rodgraneiro/UFABC-Medidor-de-Impedancia/README.md

# UFABC---Medidor-de-Impedancia

Comentário inserido por Olavo para testar o Visual Studio Code

### Exemplo de código
~~~
$ mkdir /home/olavo/github
$ cd /home/olavo/github
~~~
