rodgraneiro/UFABC-Medidor-de-Impedancia/Fcorrente_2021_06_08_prj/Circuito_eletronico_FCorrente_atual.md

# Fonte de Corrente - Circuito eletrônico atual

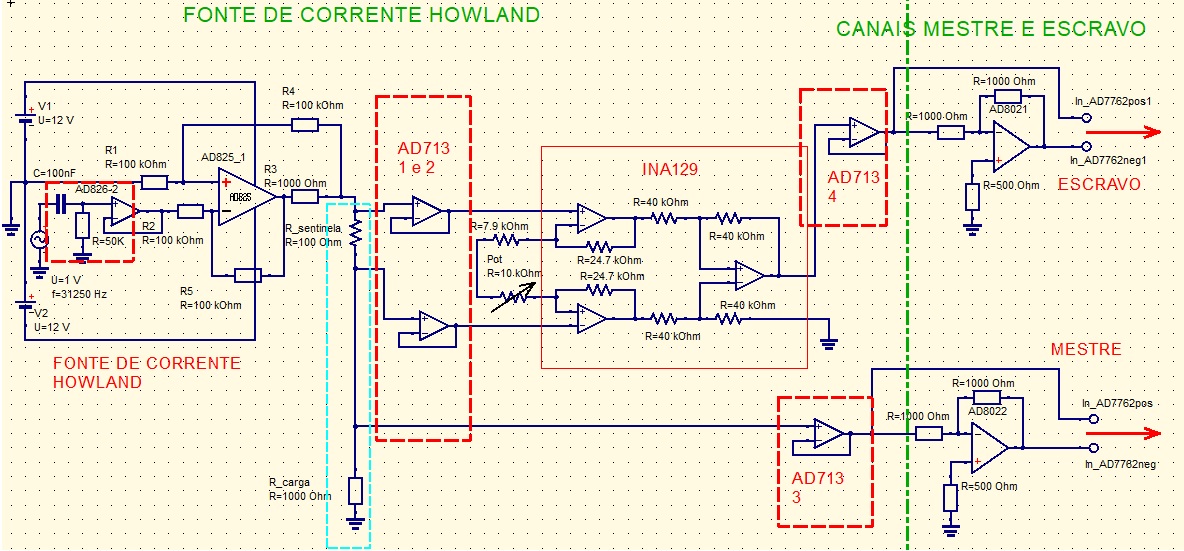
[picture p1: Fcorrente_2021_06_08_prj/FCorrente_Esquema_atual.jpg]
