rodgraneiro/UFABC-Medidor-de-Impedancia/Outros/Apresentação 625kHz.pdf

# Análise pto errático Sample Rate 156.25kHz

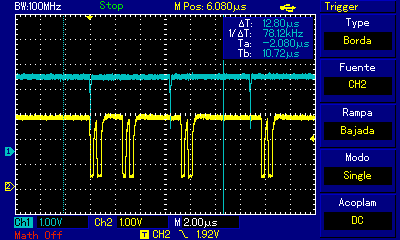
[picture p2: figure]

Foto: sinais
DRDY->

CS->

S.R. 156.25 kHz
Ch Mestre

# Nova metodologia de medição

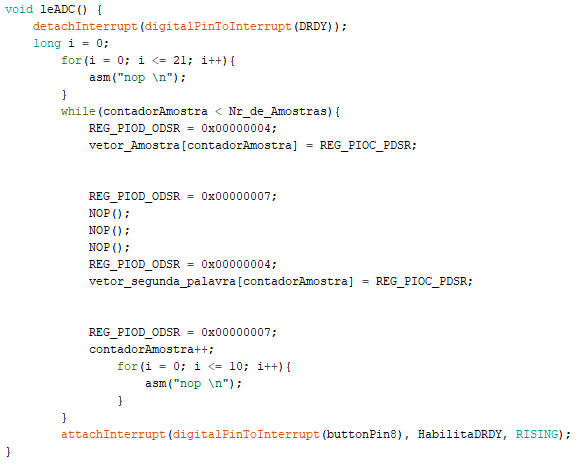
[picture p3: figure]
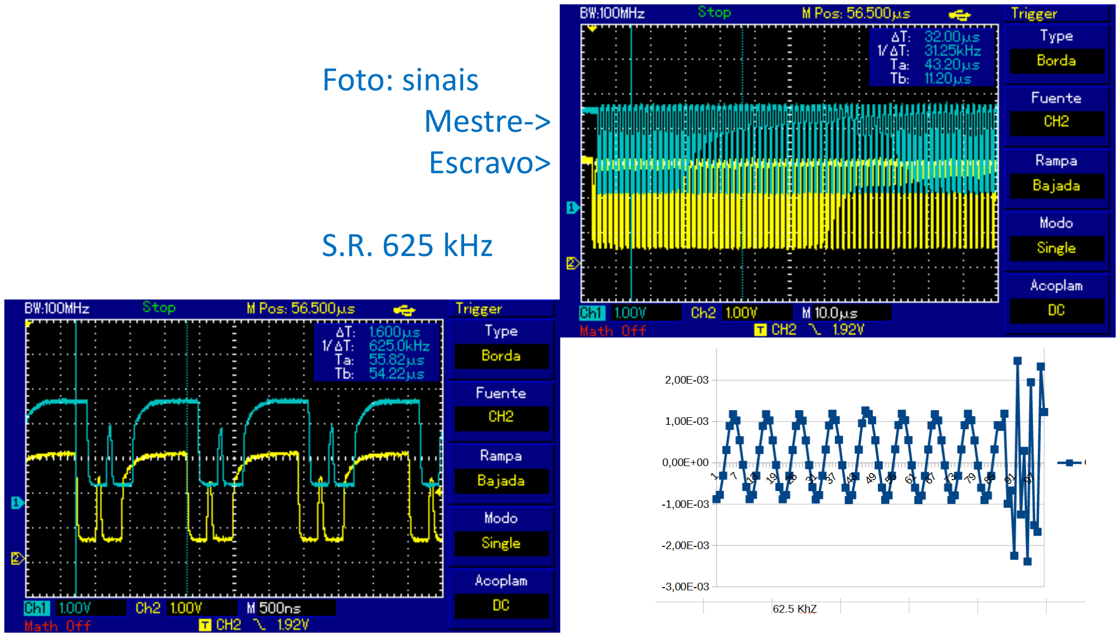
[picture p4: page 4]

Foto: sinais
Mestre->
Escravo>

S.R. 625 kHz

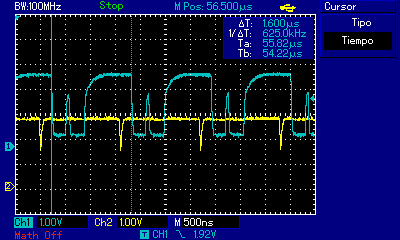
[picture p5: figure]

Foto: sinais
CS->

DRDY->

S.R. 625 kHz
Ch Mestre

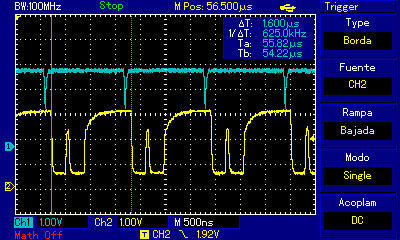
[picture p6: figure]

Foto: sinais
DRDY>

CS>

S.R. 625 kHz
Ch Escravo

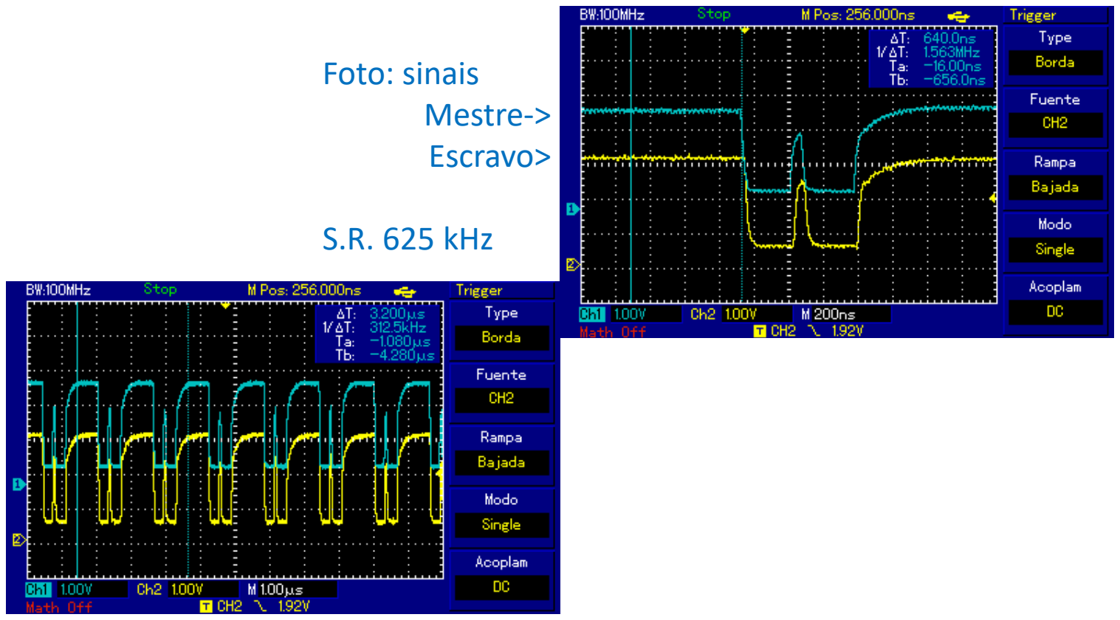
[picture p7: page 7]

Foto: sinais
Mestre->
Escravo>

S.R. 625 kHz

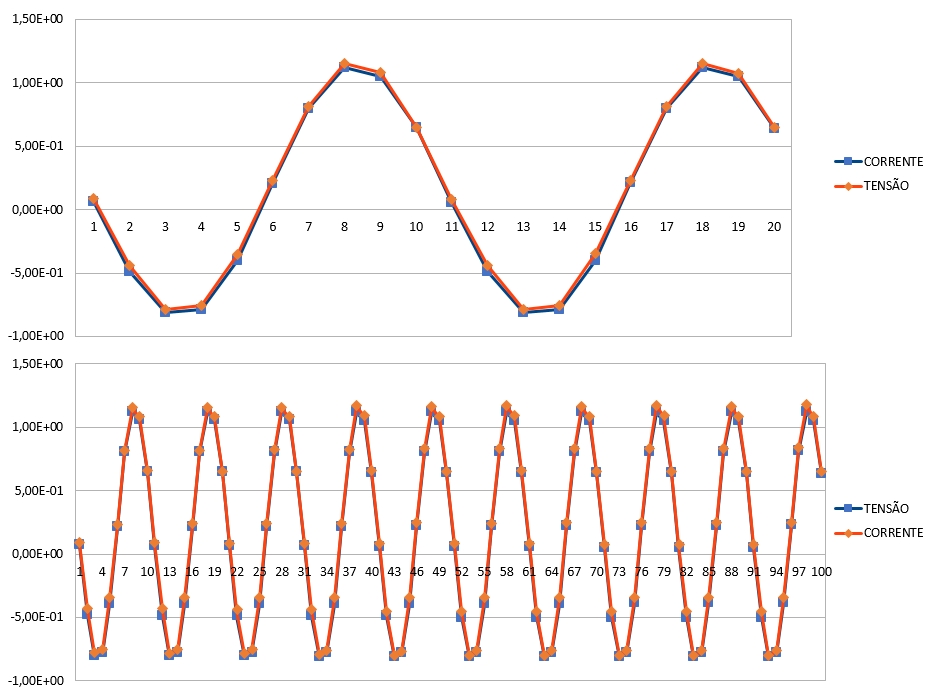
[picture p8: page 8]

Medição 1
62,5 kHz
S.R. 625 kHz

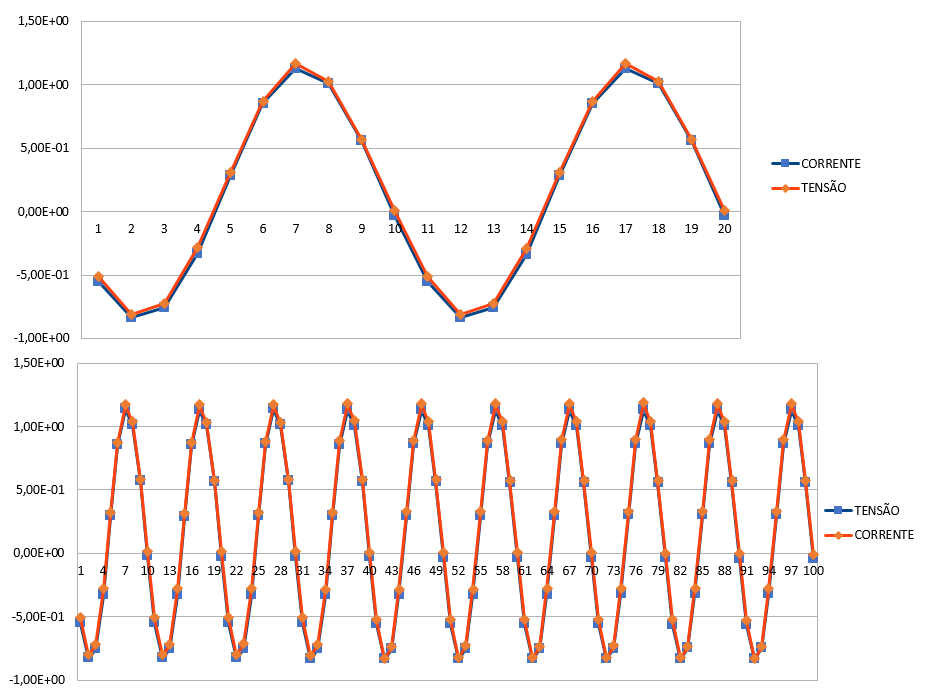
[picture p9: page 9]

Medição 2
62,5 kHz
S.R. 625 kHz

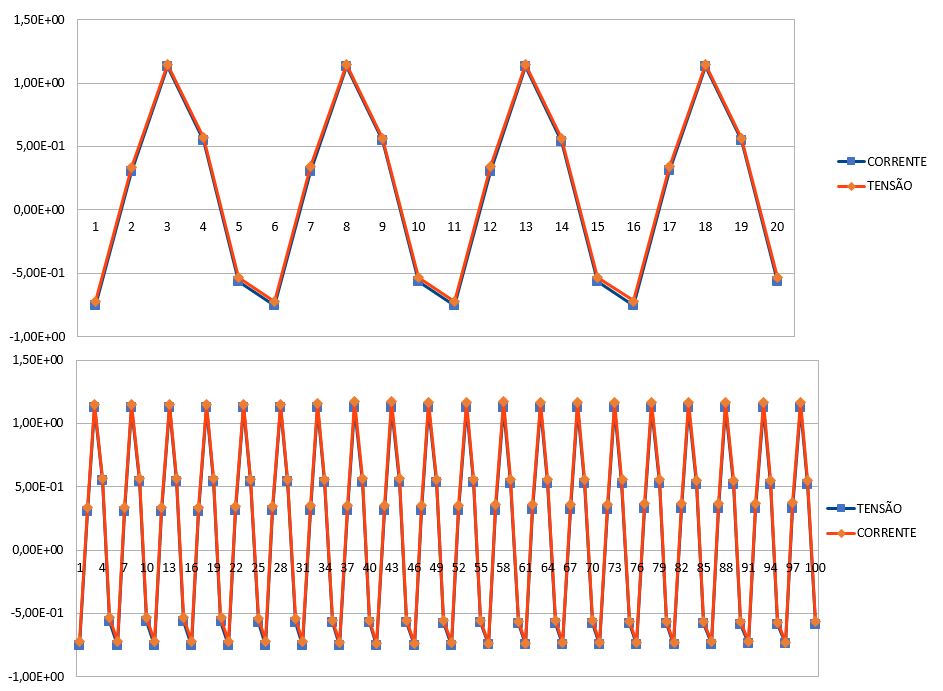
[picture p10: page 10]

Medição 3
125 kHz
S.R. 625 kHz

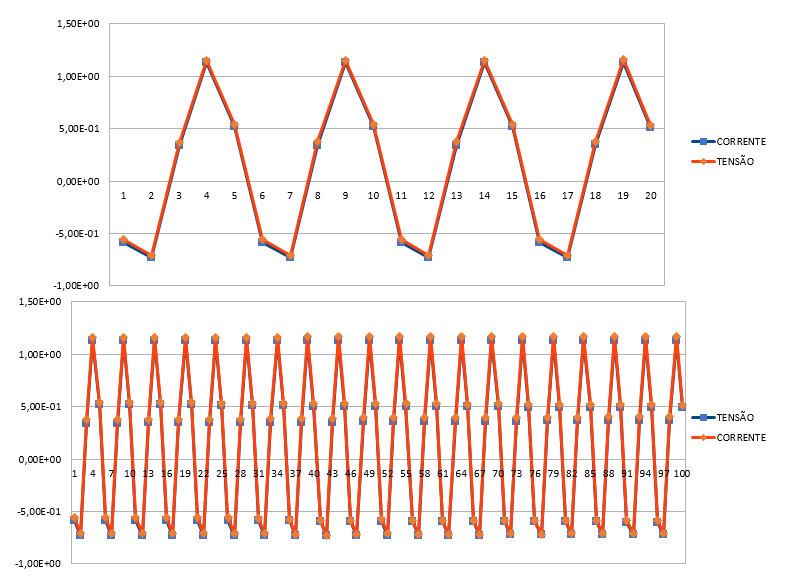
[picture p11: figure]

Medição 4
125 kHz
S.R. 625 kHz
