rodgraneiro/UFABC-Medidor-de-Impedancia/Outros/Dados para Erick completo.jpg

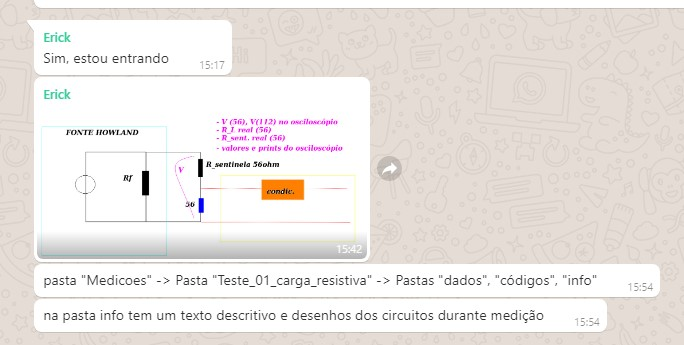
Outros/Dados para Erick completo.jpg
