rodgraneiro/UFABC-Medidor-de-Impedancia/Medicoes/Teste_03_Medicao_com RESISTORES/Info/Procedimento da medição.md

## Medição da impedânia de um trimpot tipo 3006P 103 (1K)com o MIE.

O arquivo /Dados/SoTRIMPOT.txt contém 26 pontos de medição da
resistência do trimpot com valores de zero à 2500 Ohms variando em passos de 100 Ohms
medidos com um multímetro digital e dos valores de impedância Z e fase medidas com o MIE conforme figura.
Os valores de resistividade superiores a capacidade nominal do trimpot (1k) foram medidos
com o auxílio de resistores soldados em série.

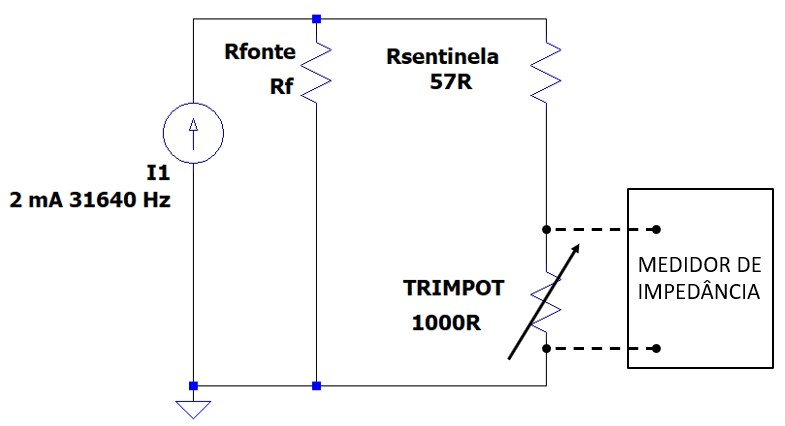
[picture p28: Medicoes/Teste_02_Medicao_com TRIMPOT/Info/Circuito_eletronico.jpg]
Circuito eletrônico do teste


Cada ponto da curva é a média trimada de mil medições efetuadas pelo MIE onde foram eliminadas
o quarcentil superior e inferior das amostras. Os cálculos foram efetuados no Matlab através do código 
/Codigo/SortMatlab_tst_new.m onde cada arquivo "TRIMPOT_r_XXXXXX_2021jul12.txt" foi substituido nas
linhas de código 2 e 3.

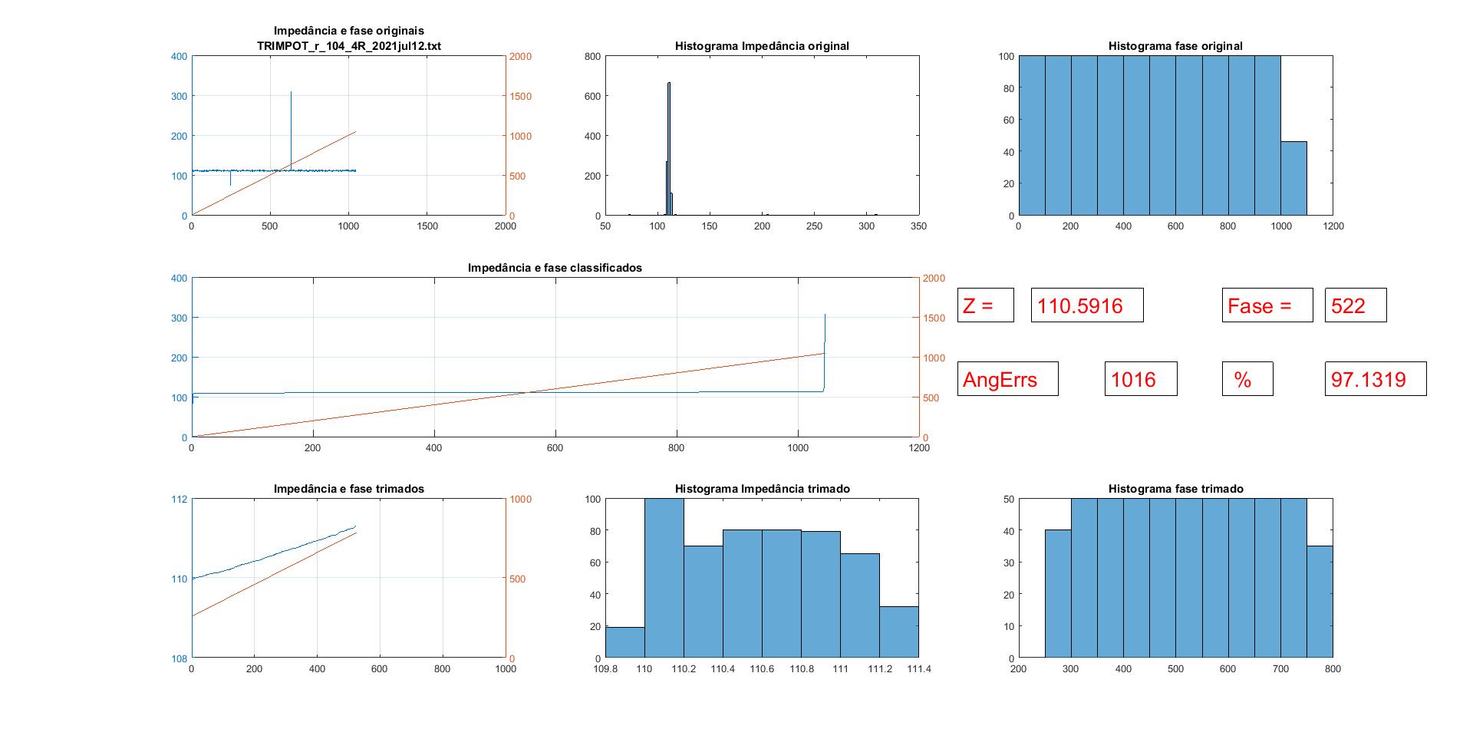
[picture p29: Medicoes/Teste_02_Medicao_com TRIMPOT/Info/ExemploMedTrimpot.jpg]
Exemplo de medição de resistividade de 100 Ohms on trimpot


A curva de Impedância Multímetro vs Impedância MIE (/Info/Curva_Z_Fase_TRIMPOT) foi efetuada através 
do código em Matlab no arquivo /Codigo/Somente_TRIMPOT.m e pode ser vista a seguir.

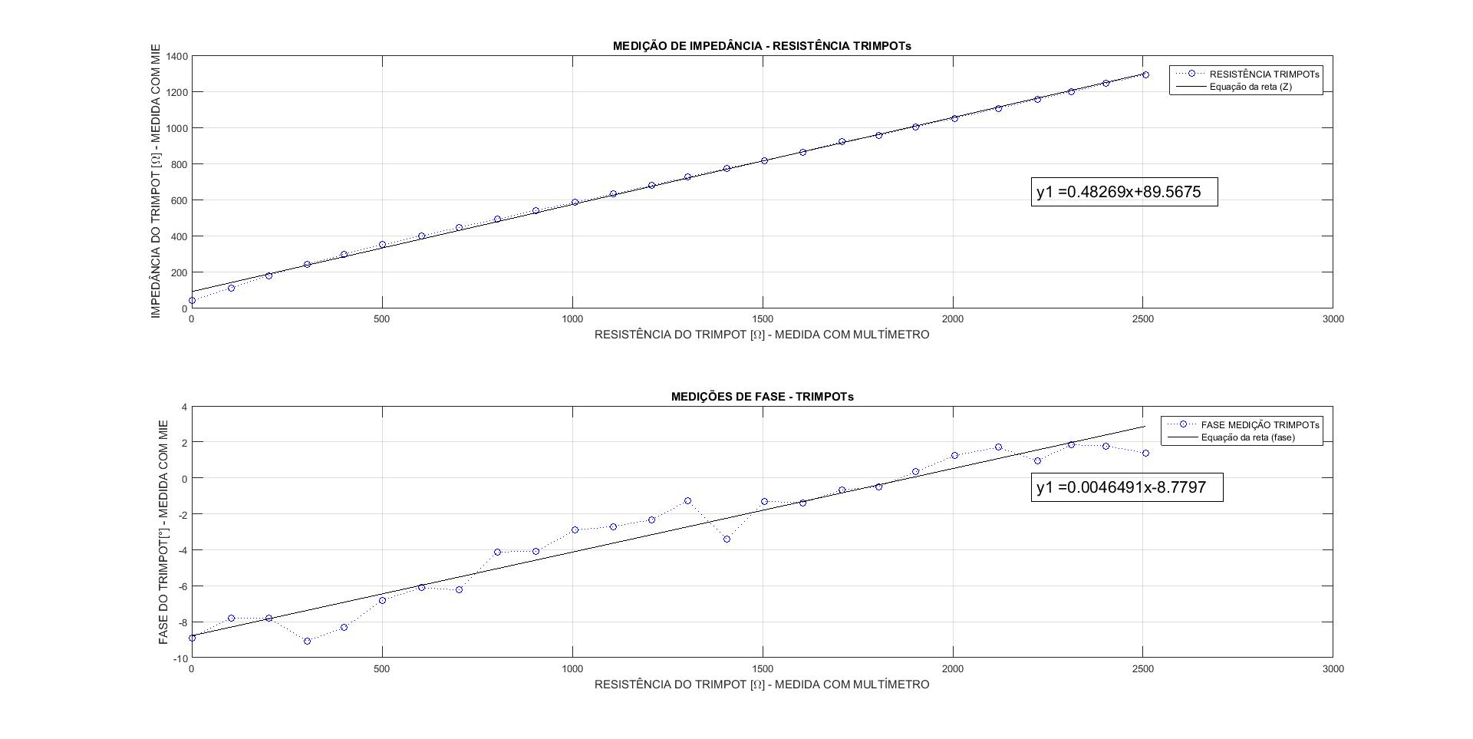
[picture p30: Medicoes/Teste_02_Medicao_com TRIMPOT/Info/Figuras/Curva_Z_Fase_TRIMPOT.jpg]
Impedância Multímetro vs Impedância MIE
 

Trimpot utilizado:

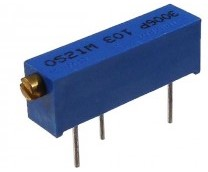
[picture p31: Medicoes/Teste_02_Medicao_com TRIMPOT/Info/Figuras/trimpot3006P.jpg]
TRIMPOT 3006P 103
