rodgraneiro/UFABC-Medidor-de-Impedancia/Medicoes/Teste_01_Resistencia_interna_FCorrente/Info/Med_Rsent_Rload_e_Frequencia.pdf

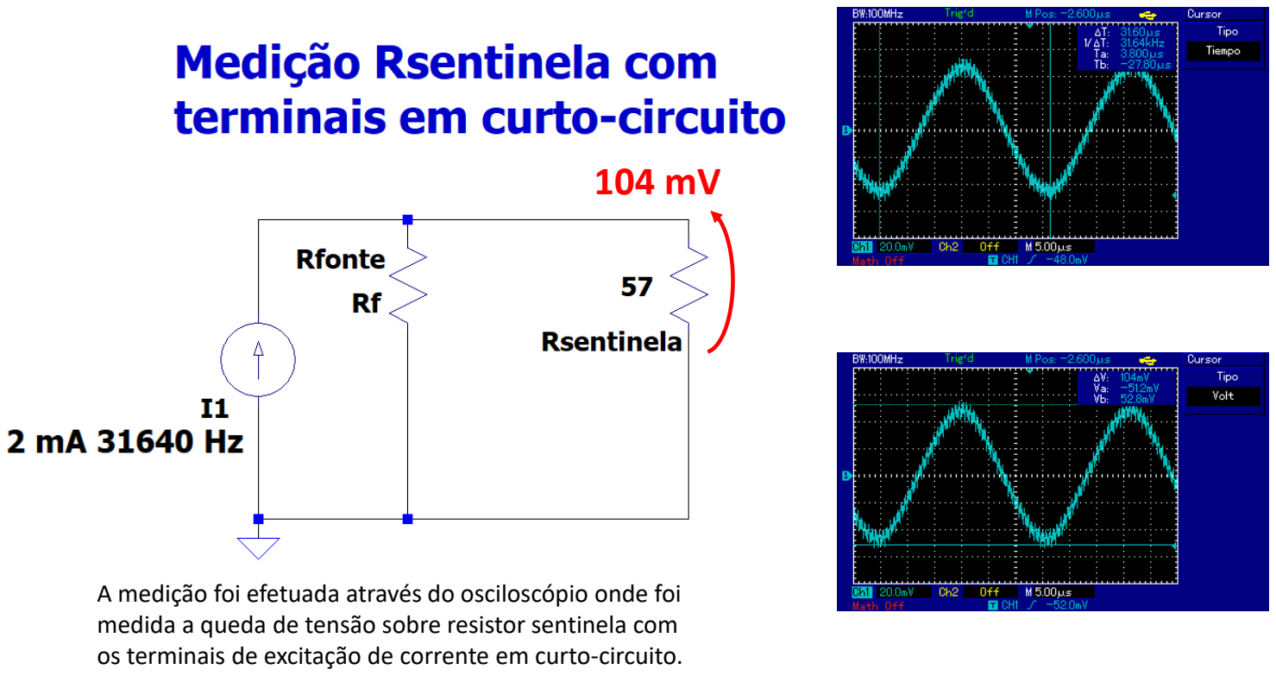
[picture p32: page 1]

104 mV

A medição foi efetuada através do osciloscópio onde foi medida a queda de tensão sobre resistor sentinela com os terminais de excitação de corrente em curto-circuito.

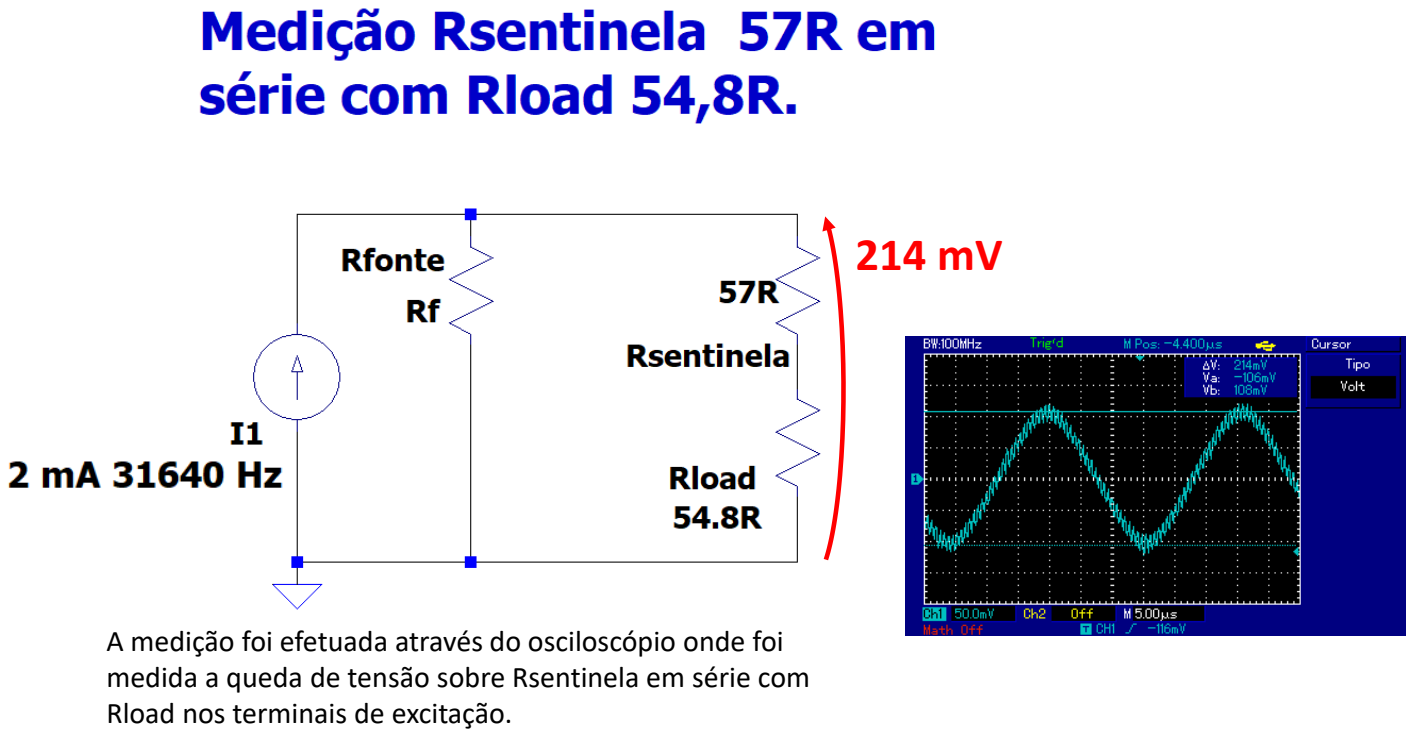
[picture p33: page 2]

214 mV

A medição foi efetuada através do osciloscópio onde foi medida a queda de tensão sobre Rsentinela em série com Rload nos terminais de excitação.
