rodgraneiro/UFABC-Medidor-de-Impedancia/Medicoes/Teste_01_Resistencia_interna_FCorrente/Dados/estudoCabecalho_DAT.xlsx

Sheet: Planilha1
0 | 0 | 0 | 0 | 0
17402 | 17224 | 17096 | 16968 | 16800 | 178 | 128 | 128 | 168
0 | 0 | 0 | 0 | 0
17530 | 17530 | 17530 | 17530 | 17530
129 | 129 | 129 | 129 | 129
3 | 3 | 3 | 3 | 3
12 | 12 | 12 | 12 | 12
2321 | 2320 | 2319 | 2318 | 2317 | 1 | 1 | 1 | 1
0 | 0 | 0 | 0 | 0
130 | 105 | 155 | 113 | 121
144 | 106 | 155 | 110 | 120
112 | 110 | 152 | 108 | 119
106 | 121 | 147 | 107 | 117
112 | 135 | 140 | 106 | 116
145 | 148 | 133 | 105 | 116
129 | 155 | 127 | 105 | 114
106 | 149 | 119 | 105 | 114
106 | 137 | 115 | 106 | 112
127 | 123 | 109 | 106 | 111
146 | 112 | 106 | 108 | 110
114 | 106 | 106 | 109 | 109
106 | 106 | 105 | 112 | 108
110 | 108 | 106 | 115 | 108
141 | 116 | 110 | 118 | 107
132 | 129 | 114 | 120 | 106
107 | 142 | 120 | 124 | 106
105 | 153 | 126 | 127 | 105
123 | 153 | 133 | 131 | 105
149 | 143 | 139 | 133 | 105
116 | 129 | 146 | 137 | 105
105 | 116 | 151 | 140 | 105
108 | 108 | 154 | 144 | 105
138 | 105 | 156 | 146 | 105
134 | 107 | 154 | 149 | 105
108 | 113 | 150 | 152 | 106
106 | 124 | 145 | 153 | 106
120 | 139 | 139 | 154 | 106
152 | 150 | 131 | 155 | 106
119 | 155 | 124 | 155 | 107
106 | 147 | 118 | 155 | 108
108 | 134 | 113 | 155 | 107
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
