rodgraneiro/UFABC-Medidor-de-Impedancia/Medicoes/Teste_06_Superficie_3D_R_C_Xc_Z/Dados/Dados_simulacao_Z_LTSpice_R_paral_C.xlsx

Sheet: R2350
 |  | MIE |  | LTSpice |  | DIFERENÇA
 |  | |z| | fase | |z| | fase | |z| | fase
2350 | 1.02e-06 | 39.26 | -13.99 | 4.98 | -89.87 | 34.28 | 75.88
2350 | 4.7e-07 | 39.92 | -19.66 | 10.83 | -89.73 | 29.09 | 70.07
2350 | 3.37e-07 | 40.53 | -24.09 | 15.13 | -89.63 | 25.40 | 65.54
2350 | 2.26e-07 | 42.75 | -30.4 | 22.53 | -89.45 | 20.22 | 59.05
2350 | 1.01e-07 | 53.14 | -49.4 | 50.41 | -88.77 | 2.73 | 39.37
2350 | 4.75e-08 | 87.87 | -69.52 | 107.11 | -87.39 | -19.24 | 17.87
2350 | 2.02e-08 | 142.27 | -77.37 | 250.69 | -83.88 | -108.42 | 6.51
2350 | 1.03e-08 | 328.57 | -78.36 | 493.03 | -77.89 | -164.46 | -0.47
2350 | 4.2e-09 | 607.09 | -60.78 | 1078.00 | -62.71 | -470.91 | 1.93
2350 | 3.2e-09 | 756.94 | -50.72 | 1318.00 | -55.89 | -561.06 | 5.17
2350 | 2.82e-09 | 812.66 | -46.81 | 1432.00 | -52.46 | -619.34 | 5.65
2350 | 2.53e-09 | 873.74 | -42.81 | 1529.00 | -49.42 | -655.26 | 6.61
39.26 | 39.92 | 40.53 | 42.75 | 53.14 | 87.87 | 142.27 | 328.57 | 607.09 | 756.94 | 812.66 | 873.74
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
