rodgraneiro/UFABC-Medidor-de-Impedancia/Medicoes/Teste_01_Resistencia_interna_FCorrente/Info/Medicao_tensao_corrente_osciloscopio.xlsx

Rsentinela | Rload | Rtotal | Delta_V | Itotal
[OHM] | [OHM] | [OHM] | [mVp-p] | [mApp]
57 | 0 | 57 | 101 | 1.77
57 | 1.1 | 58.1 | 102 | 1.76
57 | 5.1 | 62.1 | 113 | 1.82
57 | 9.8 | 66.8 | 119 | 1.78
57 | 14.9 | 71.9 | 126 | 1.75
57 | 27.5 | 84.5 | 136 | 1.61
57 | 54.8 | 111.8 | 200 | 1.79
57 | 99.5 | 156.5 | 300 | 1.92
57 | 219.8 | 276.8 | 548 | 1.98
57 | 297 | 354 | 684 | 1.93
57 | 497 | 554 | 1080 | 1.95
57 | 667 | 724 | 1380 | 1.91
57 | 1630 | 1687 | 3140 | 1.86
57 | 1941 | 1998 | 3760 | 1.88
57 | 2350 | 2407 | 4360 | 1.81
