rodgraneiro/UFABC-Medidor-de-Impedancia/Medicoes/Teste_01_Resistencia_interna_FCorrente/Dados/Medicao_tensao_corrente_osciloscopio.xlsx

Rsentinela | Rload | Rtotal | Delta_V | Itotal
[OHM] | [OHM] | [OHM] | [mVp-p] | mApp
57 | 0 | 57 | 101 | 1.771929825
57 | 1.1 | 58.1 | 102 | 1.755593804
57 | 5.1 | 62.1 | 113 | 1.819645733
57 | 9.8 | 66.8 | 119 | 1.781437126
57 | 14.9 | 71.9 | 126 | 1.752433936
57 | 27.5 | 84.5 | 136 | 1.609467456
57 | 54.8 | 111.8 | 200 | 1.788908766
57 | 99.5 | 156.5 | 300 | 1.916932907
57 | 219.8 | 276.8 | 548 | 1.979768786
57 | 297 | 354 | 684 | 1.93220339
57 | 497 | 554 | 1080 | 1.949458484
57 | 667 | 724 | 1380 | 1.906077348
57 | 1630 | 1687 | 3140 | 1.861292235
57 | 1941 | 1998 | 3760 | 1.881881882
57 | 2350 | 2407 | 4360 | 1.811383465
