rodgraneiro/UFABC-Medidor-de-Impedancia/Medicoes/Teste_02_Medicao_com TRIMPOT/Dados/TRIMPOT.xlsx

TRIMPOT | MIE | fase | erros | %
0 | 39.21 | -8.9 | 52 | 4.96
104.4 | 110.59 | -7.79 | 39 | 3.72
201.9 | 178.02 | -7.8 | 37 | 3.55
302.9 | 241.13 | -9.07 | 43 | 4.11
401 | 296.99 | -8.33 | 56 | 5.35
501 | 349.02 | -6.8 | 36 | 3.46
603 | 398.35 | -6.11 | 39 | 3.72
702 | 445.12 | -6.23 | 54 | 5.15
