rodgraneiro/UFABC-Medidor-de-Impedancia/Medicoes/Teste_Laboratorio_L001/1cope_0sinc_01curto_.csv

-100.600E-06 -7.574592E-03
-100.500E-06 -23.081815E-03
-100.400E-06 -12.670383E-03
-100.300E-06 -5.643059E-03
-100.200E-06 -28.130496E-03
-100.100E-06 -34.121388E-03
-100.000E-06 -40.787531E-03
-99.900E-06 -23.403737E-03
-99.800E-06 -13.997330E-03
-99.700E-06 -6.467494E-03
-99.600E-06 -25.947707E-03
-99.500E-06 -33.571765E-03
-99.400E-06 -37.340609E-03
-99.300E-06 +881.753E-06
-99.200E-06 +709.014E-06
-99.100E-06 -2.800722E-03
-99.000E-06 -20.639918E-03
-98.900E-06 -10.212782E-03
-98.800E-06 -2.965609E-03
-98.700E-06 +2.467808E-03
-98.600E-06 +3.912531E-03
-98.500E-06 -350.974E-06
-98.400E-06 -19.956815E-03
-98.300E-06 -10.322707E-03
-98.200E-06 -3.373901E-03
-98.100E-06 -1.952732E-03
-98.000E-06 -18.221576E-03
-97.900E-06 -7.456815E-03
-97.800E-06 -1.544441E-03
-97.700E-06 -22.704931E-03
-97.600E-06 -29.622330E-03
-97.500E-06 -34.749528E-03
-97.400E-06 -18.645571E-03
-97.300E-06 -7.166300E-03
-97.200E-06 -115.421E-06
-97.100E-06 -20.977544E-03
-97.000E-06 -26.976287E-03
-96.900E-06 -30.823649E-03
-96.800E-06 +6.527167E-03
-96.700E-06 +7.437971E-03
-96.600E-06 +2.444253E-03
-96.500E-06 -15.944566E-03
-96.400E-06 -4.002041E-03
-96.300E-06 +9.369504E-03
-96.200E-06 +9.086840E-03
-96.100E-06 +10.413788E-03
-96.000E-06 +1.894629E-03
-95.900E-06 -15.135835E-03
-95.800E-06 -4.763662E-03
-95.700E-06 +3.747645E-03
-95.600E-06 +3.182318E-03
-95.500E-06 -11.555433E-03
-95.400E-06 -2.730056E-03
-95.300E-06 +4.203047E-03
-95.200E-06 -17.687657E-03
-95.100E-06 -25.688599E-03
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
+98.300E-06 +20.848775E-03
+98.400E-06 +15.556690E-03
+98.500E-06 +1.070195E-03
+98.600E-06 +6.699906E-03
+98.700E-06 +17.441112E-03
+98.800E-06 +29.336526E-03
+98.900E-06 +21.343436E-03
+99.000E-06 +15.760835E-03
+99.100E-06 -5.572393E-03
+99.200E-06 +2.161589E-03
+99.300E-06 +10.877041E-03
