rodgraneiro/UFABC-Medidor-de-Impedancia/Medicoes/Teste_Laboratorio_L001/curto_ruido_02.csv

x-axis | 1
second | Volt
-700.0000E-09 | -47.1529515817E-03
-699.6875E-09 | -75.3093583153E-03
-699.3750E-09 | -87.1184034149E-03
-699.0625E-09 | -103.4500615315E-03
-698.7500E-09 | -122.2942824352E-03
-698.4375E-09 | -131.5907647477E-03
-698.1250E-09 | -159.7314679639E-03
-697.8125E-09 | -168.5254377189E-03
-697.5000E-09 | -175.7961662843E-03
-697.1875E-09 | -167.7559653654E-03
-696.8750E-09 | -152.9318449211E-03
-696.5625E-09 | -131.5750612303E-03
-696.2500E-09 | -107.7057147522E-03
-695.9375E-09 | -95.3941570951E-03
-695.6250E-09 | -79.3137552573E-03
-695.3125E-09 | -79.3137552573E-03
-695.0000E-09 | -79.3294587747E-03
-694.6875E-09 | -87.3696596936E-03
-694.3750E-09 | -92.3947852680E-03
-694.0625E-09 | -99.4299610720E-03
-693.7500E-09 | -104.9575992038E-03
-693.4375E-09 | -107.4701619909E-03
-693.1250E-09 | -119.5147598519E-03
-692.8125E-09 | -119.5147598519E-03
-692.5000E-09 | -119.5147598519E-03
-692.1875E-09 | -103.4343580141E-03
-691.8750E-09 | -91.8765691931E-03
-691.5625E-09 | -75.2936547979E-03
-691.2500E-09 | -46.1479264668E-03
-690.9375E-09 | -31.0725497438E-03
-690.6250E-09 | -6.9519469871E-03
-690.3125E-09 | +5.8621232274E-03
-690.0000E-09 | +17.1686557696E-03
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
