rodgraneiro/UFABC-Medidor-de-Impedancia/Medicoes/Teste_Laboratorio_L001/rl_658r.csv

x-axis | 1
second | Volt
-250.6000E-06 | +87.6491787E-03
-250.3500E-06 | +119.1347311E-03
-250.1000E-06 | +145.9877459E-03
-249.8500E-06 | +176.2955345E-03
-249.6000E-06 | +212.0210367E-03
-249.3500E-06 | +234.0059610E-03
-249.1000E-06 | +269.4173928E-03
-248.8500E-06 | +300.9814628E-03
-248.6000E-06 | +329.7188997E-03
-248.3500E-06 | +360.0266883E-03
-248.1000E-06 | +393.1611101E-03
-247.8500E-06 | +412.7905069E-03
-247.6000E-06 | +444.5116121E-03
-247.3500E-06 | +471.2861093E-03
-247.1000E-06 | +493.8206568E-03
-246.8500E-06 | +519.0248022E-03
-246.6000E-06 | +546.9770632E-03
-246.3500E-06 | +564.3294500E-03
-246.1000E-06 | +592.4387462E-03
-245.8500E-06 | +613.4814595E-03
-245.6000E-06 | +631.7760573E-03
-245.3500E-06 | +651.9550772E-03
-245.1000E-06 | +670.0926398E-03
-244.8500E-06 | +678.1799513E-03
-244.6000E-06 | +695.5323380E-03
-244.3500E-06 | +703.3840967E-03
-244.1000E-06 | +707.9381168E-03
-243.8500E-06 | +717.9098503E-03
-243.6000E-06 | +719.5587197E-03
-243.3500E-06 | +711.5499258E-03
-243.1000E-06 | +716.7320865E-03
-242.8500E-06 | +712.3351017E-03
-242.6000E-06 | +701.5781922E-03
-242.3500E-06 | +694.5116094E-03
-242.1000E-06 | +678.8080920E-03
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
