rodgraneiro/UFABC-Medidor-de-Impedancia/Medicoes/Teste_Laboratorio_L001/scope_09.csv

x-axis | 1 | 2 | 3
second | Volt | Volt | Volt
-5.000000E-06 | +2.617964848876E+00 | +2.472864292562E+00 | +1.094302767888E+00
-4.995000E-06 | +2.778768867254E+00 | +2.633668310940E+00 | +1.094302767888E+00
-4.990000E-06 | +2.457160830498E+00 | +2.553266301751E+00 | +1.094302767888E+00
-4.985000E-06 | +2.537562839687E+00 | +2.633668310940E+00 | +1.094302767888E+00
-4.980000E-06 | +2.296356812119E+00 | +2.472864292562E+00 | +1.094302767888E+00
-4.975000E-06 | +2.612939723302E+00 | +2.472864292562E+00 | +1.094302767888E+00
-4.970000E-06 | +2.617964848876E+00 | +2.714070320129E+00 | +1.094302767888E+00
-4.965000E-06 | +2.537562839687E+00 | +2.553266301751E+00 | +1.094302767888E+00
-4.960000E-06 | +2.612939723302E+00 | +2.633668310940E+00 | +1.094302767888E+00
-4.955000E-06 | +2.371733695734E+00 | +2.472864292562E+00 | +1.094302767888E+00
-4.950000E-06 | +2.612939723302E+00 | +2.392462283373E+00 | +1.094302767888E+00
-4.945000E-06 | +2.693341732491E+00 | +2.709045194555E+00 | +1.094302767888E+00
-4.940000E-06 | +2.537562839687E+00 | +2.553266301751E+00 | +1.094302767888E+00
-4.935000E-06 | +2.612939723302E+00 | +2.553266301751E+00 | +1.094302767888E+00
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
