rodgraneiro/UFABC-Medidor-de-Impedancia/Medicoes/Teste_Laboratorio_L001/scope_0sinc_01.csv

x-axis | 1 | 2 | 3
second | Volt | Volt | Volt
-4.200000E-06 | +2.694874338806E+00 | +2.448241200298E+00 | +2.505025125574E+00
-4.195000E-06 | +2.373266302049E+00 | +2.372864316683E+00 | +2.660804018378E+00
-4.190000E-06 | +2.363216050901E+00 | +2.448241200298E+00 | +2.580402009189E+00
-4.185000E-06 | +2.534070320427E+00 | +2.372864316683E+00 | +2.419597990811E+00
-4.180000E-06 | +2.624522580765E+00 | +2.774874362629E+00 | +2.344221107196E+00
-4.175000E-06 | +2.684824087657E+00 | +2.523618083913E+00 | +2.500000000000E+00
-4.170000E-06 | +2.453668311238E+00 | +2.403015070129E+00 | +2.620603013784E+00
-4.165000E-06 | +2.373266302049E+00 | +2.370351753896E+00 | +2.575376883615E+00
-4.160000E-06 | +2.458693436813E+00 | +2.410552758491E+00 | +2.457286432618E+00
-4.155000E-06 | +2.684824087657E+00 | +2.729648232460E+00 | +2.379396986216E+00
-4.150000E-06 | +2.684824087657E+00 | +2.450753763085E+00 | +2.464824120980E+00
-4.145000E-06 | +2.373266302049E+00 | +2.443216074724E+00 | +2.620603013784E+00
-4.140000E-06 | +2.373266302049E+00 | +2.408040195704E+00 | +2.580402009189E+00
-4.135000E-06 | +2.458693436813E+00 | +2.408040195704E+00 | +2.457286432618E+00
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
