rodgraneiro/UFABC-Medidor-de-Impedancia/Medicoes/Teste_01_Resistencia_interna_FCorrente/Info/Amplitude_Rsentinela_mais_Rload.jpg

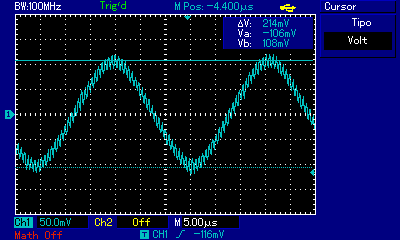
Medicoes/Teste_01_Resistencia_interna_FCorrente/Info/Amplitude_Rsentinela_mais_Rload.jpg
