rodgraneiro/UFABC-Medidor-de-Impedancia/Medicoes/Teste_04_Medicao_1_CAPACITORES/Figuras/curva_Z_fase_Xc_MED1_CAPACITORES.jpg

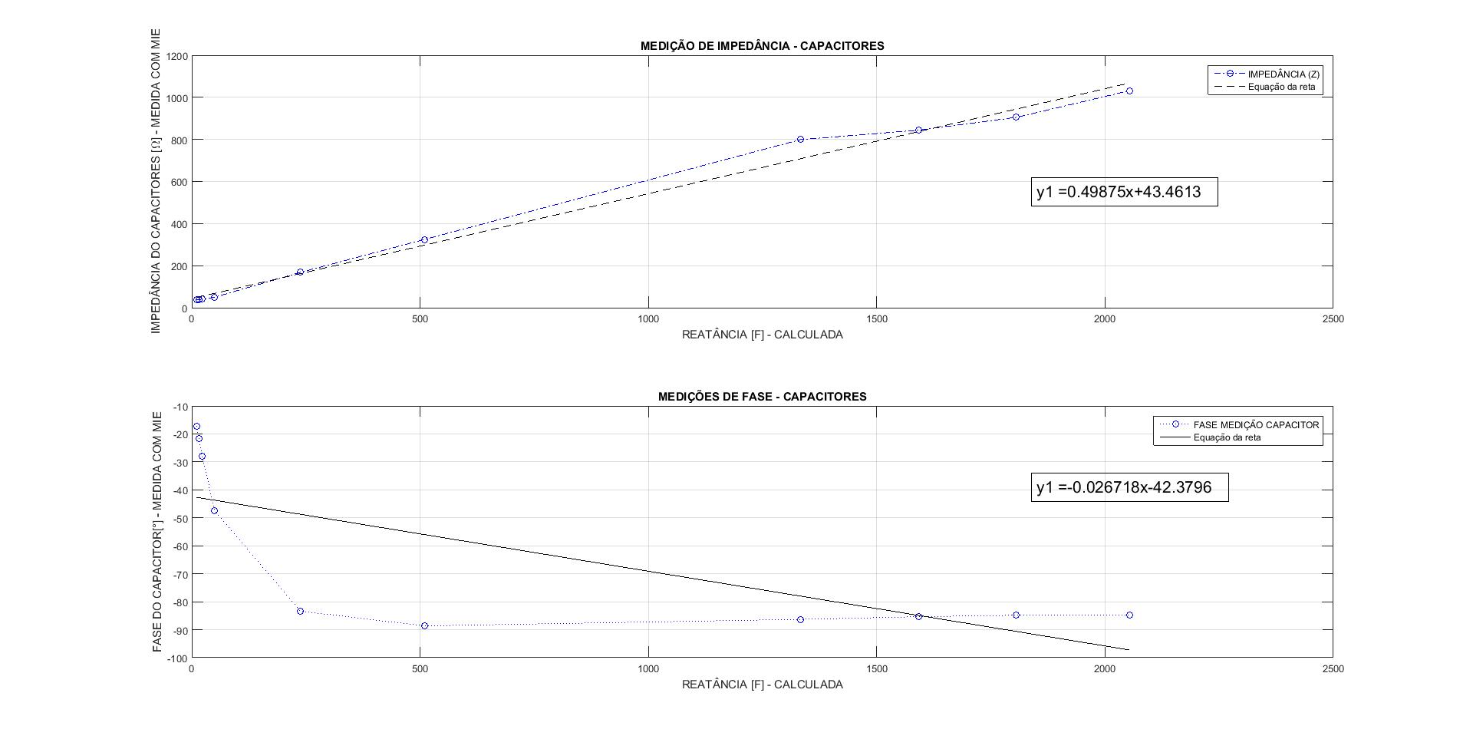
Medicoes/Teste_04_Medicao_1_CAPACITORES/Figuras/curva_Z_fase_Xc_MED1_CAPACITORES.jpg
