rodgraneiro/UFABC-Medidor-de-Impedancia/Medicoes/Teste_06_Superficie_3D_R_C_Xc_Z/Info/Circuito_eletronico_LTSpice.jpg

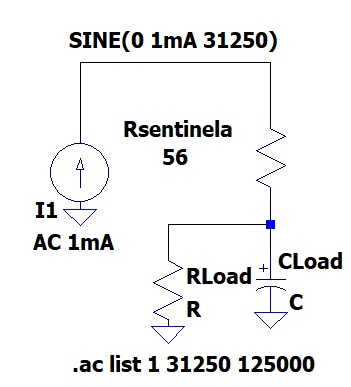
Medicoes/Teste_06_Superficie_3D_R_C_Xc_Z/Info/Circuito_eletronico_LTSpice.jpg
