rodgraneiro/UFABC-Medidor-de-Impedancia/Medicoes/Teste_Laboratorio_L001/1cope_0sinc_01curto_.png

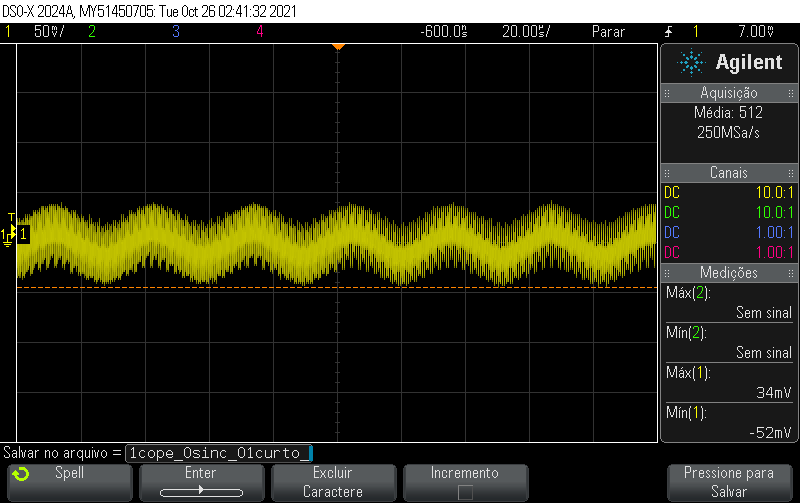
Medicoes/Teste_Laboratorio_L001/1cope_0sinc_01curto_.png
