rodgraneiro/UFABC-Medidor-de-Impedancia/Medicoes/Teste_Laboratorio_L001/curto_ruido_01.png

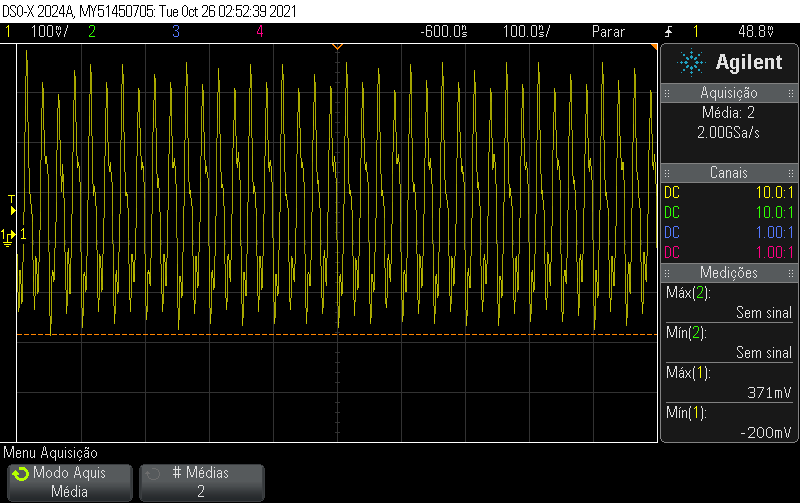
Medicoes/Teste_Laboratorio_L001/curto_ruido_01.png
