rodgraneiro/UFABC-Medidor-de-Impedancia/Medicoes/Teste_Laboratorio_L001/rl_658rpng_.png

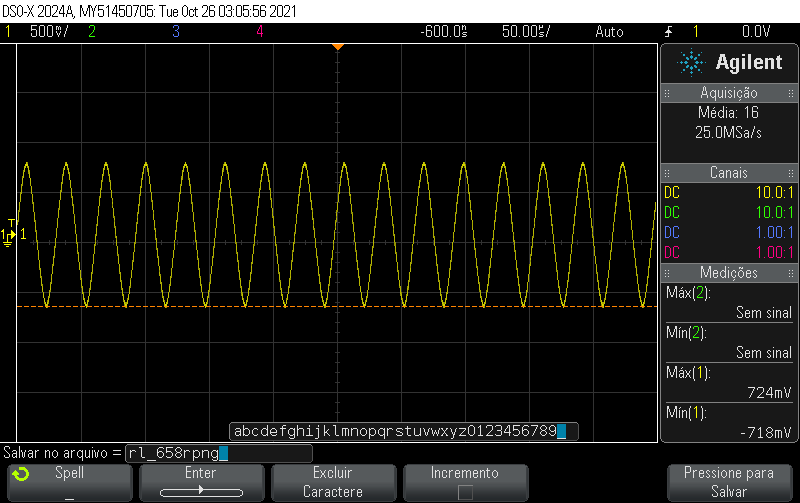
Medicoes/Teste_Laboratorio_L001/rl_658rpng_.png
