rodgraneiro/UFABC-Medidor-de-Impedancia/Medicoes/Teste_Laboratorio_L001/scope_10zzzwy_.bmp

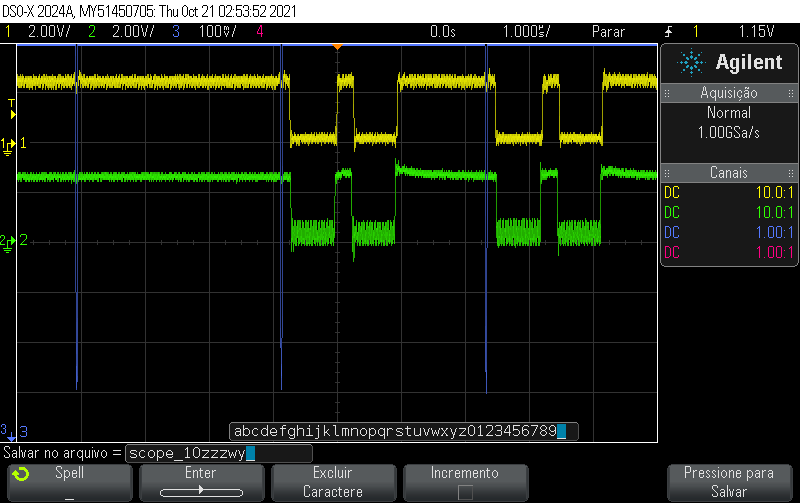
Medicoes/Teste_Laboratorio_L001/scope_10zzzwy_.bmp
