rodgraneiro/UFABC-Medidor-de-Impedancia/Medicoes/Teste_Laboratorio_L001/seno_curto.bmp

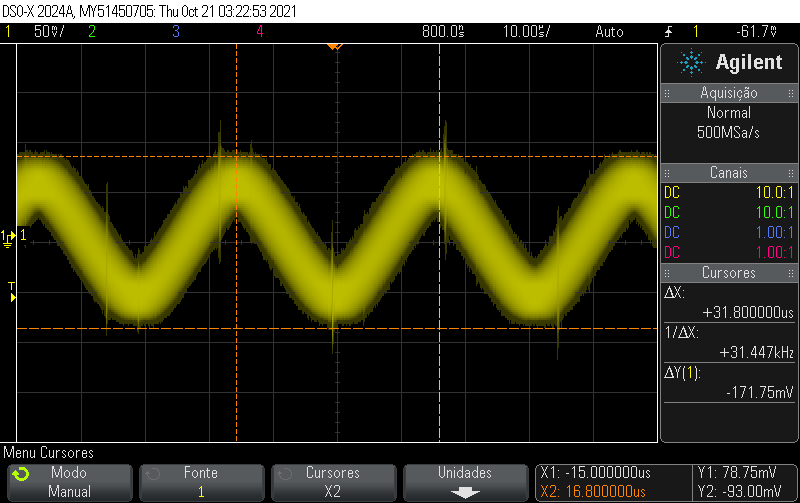
Medicoes/Teste_Laboratorio_L001/seno_curto.bmp
