rodgraneiro/UFABC-Medidor-de-Impedancia/Medicoes/Teste_06_Superficie_3D_R_C_Xc_Z/Codigo/Simu_Z_LTSpice_R_paral_C_freq_31250Hz.asc

CLoad: polcap; 0.47µ; V=50 Irms=0 Rser=0 Lser=0
I1: current; SINE(0 2mA 31250); AC 2mA
RLoad: res; 990R
Rsent: res; 57R
Named nets: 0
.ac list 31249 31250 31251
