rodgraneiro/UFABC-Medidor-de-Impedancia/Medicoes/Teste_03_Medicao_com RESISTORES/Codigo/Esquema RESISTORES.asc

I1: current; 2 mA 31640 Hz
RESISTORES: res
Rfonte: res; Rf
Rsentinela: res; 57R
Named nets: 0
.ac list 31640
