rodgraneiro/UFABC-Medidor-de-Impedancia/Medicoes/Teste_02_Medicao_com TRIMPOT/Codigo/Esquema TRIMPOT.asc

I1: current; 2 mA 31640 Hz
Rfonte: res; Rf
Rsentinela: res; 57R
TRIMPOT: res; 1000R
Named nets: 0
.ac list 31640
