rodgraneiro/UFABC-Medidor-de-Impedancia/Medicoes/Teste_01_Resistencia_interna_FCorrente/Codigos/Med_Resistencia_interna_FCorrente.asc

I1: current; 2 mA 31640 Hz
Rfonte: res; Rf
Rload: res; 54.8R
Rsentinela: res; 57R
Named nets: 0
.ac list 31640
Medição Rsentinela  57R em 
série com Rload 54,8R.
