rodgraneiro/UFABC-Medidor-de-Impedancia/(commit log)

2021-03-09 Teste de comentario do Olavo
2021-03-09 Exemplo de código no formato md
2021-03-23 revisão de variáveis
2021-03-29 correção inteiro da fase
    Obs. a variável tipo "byte" só pode transmitir via I2C ângulos de até 255 graus.
2021-04-04 alteração union float I2C
    Conversão de float para 4 bytes para transmissão I2C
2021-04-05 debug I2C
2021-04-06 debug I2C 05abr21
2021-04-18 debug error ptos 18abr21
    [canalMestre.ino, canalSlave.ino]
2021-05-04 medições pto erráticos
    [mil_master_02mai21_1.ods, mil_master_02mai21_2.ods, mil_slave_02mai21_1.ods, mil_slave_02mai21_2.ods, mil_slave_03mai21_1.ods]
2021-05-11 Arquivos - medição gráfico processing
    [tst_mil_file_graf_08mai21_1.ods]
2021-09-30 Create Medição Rsentinela com terminais em curto-circuito
2021-09-30 Update Medição Rsentinela com terminais em curto-circuito
2021-10-02 Update and rename Procedimento da medição.md to Procedimento med RESISTORES.md
2021-10-02 Update Procedimento med RESISTORES.md
2021-10-02 Update and rename Medição Rsentinela com terminais em curto-circuito to Medicao_impedancia_interna_FCorrente.md
2022-01-11 Programas para estutar a calibracao.
2022-01-11 Adaptacao para Matlab
2022-02-22 Adicionando funcao para trimar os vetores.
2022-03-03 back up old files
    [med2_mil_master_24abr21_1.ods, mil_master_02mai21_1.ods, mil_master_02mai21_2.ods, mil_slave_02mai21_1.ods, mil_slave_02mai21_2.ods, mil_slave_03mai21_1.ods]
